M100ika/Kulager_Horse/electrical/power/concept-rA.md

# Питание и резерв батареи rA

В CAD оставлен объём 180 × 70 × 65 мм под готовую защищённую батарею.
Геометрия пакета, химия и ёмкость **не подтверждены**. Для расчёта автономности
принят пример 25,6 В, 4 А·ч (8S LiFePO4), 102,4 Вт·ч; напряжение полного заряда
при 3,65 В/ячейку — 29,2 В. Такой пакет и BMS должны реально помещаться в резерв.

[Страница CubeMars](https://www.cubemars.com/goods.php?id=1143) указывает варианты
24/48 В. Это не подтверждает полный рабочий диапазон имеющейся платы. Перед
подключением сверить конкретный драйвер, минимальное/максимальное напряжение,
пороги защиты и запас под рекуперацию. Для 48-вольтовой версии пакет надо
выбирать заново; 13S Li-ion с 54,6 В нельзя автоматически считать совместимым.
До подтверждения использовать лабораторное питание подходящего диапазона
с ограничением тока. Обычный лабораторный БП может не принимать рекуперацию.

Предлагаемая силовая цепь:

```text
Батарея с BMS → предохранитель у батареи → главный выключатель
  ├─ DC/DC → ESP32 + датчики + журнал отказов
  └─ предзаряд + силовой DC-контактор → шина → предохранители ветвей → 2 мотора

E-stop (NC) + проводной dead-man + аппаратный watchdog
  → аппаратное разрешение → контактор и обе нормально разомкнутые муфты

Шина: измерение напряжения, ёмкость, согласованная защита от рекуперации.
```

Номиналы предохранителей, проводов, контактора, BMS и DC/DC определяются по
измеренным пусковым/рабочим токам, току КЗ, длительности импульса, температуре
и характеристикам отключения. Паспортные 7/19 А мотора не следует без проверки
трактовать как максимальный ток батареи. Ограничение тока БП не заменяет
ограничение силы на поводе.

При эффективной доле энергии 0,8 и среднем потреблении 25/50/100 Вт получаем
примерно 3,28/1,64/0,82 ч. Это сценарии, не обещанная автономность. Измерять
потребление с муфтами и удержанием нагрузки, а также температуру батареи и
моторов. При низком заряде снять натяжение и разомкнуть привод до отключения
BMS. При обрыве питания механика должна отпускать без участия аккумулятора.

CAN: линейная шина, два терминатора 120 Ом на физических концах, короткие
ответвления, CAN_H/CAN_L витой парой, согласованная опорная земля/изоляция.
ESP32 требует [внешнего трансивера](https://docs.espressif.com/projects/esp-idf/en/v5.4/esp32/api-reference/peripherals/twai.html).
Разъёмы драйвера, распиновку, ID и скорость сверить по ревизии его документации.
Нельзя смешивать пакетный формат MIT и servo и считать их взаимозаменяемыми.
