M100ika/Kulager_Horse/mechanical/calculations/concept-rA.md

# Предварительные расчёты rA

Это расчёты выбора компоновки, не заключение о прочности или допустимом
воздействии на животное. Источник данных двигателя:
[CubeMars AK80-64](https://www.cubemars.com/goods.php?id=1143).

## Момент и ход

При рабочем радиусе барабана r = 0,025 м: F = T/r, T = F·r.

| Условие | Момент, Н·м | Сила на барабане, Н |
|---|---:|---:|
| Начальная проверка на стенде | 0,125 | 5 |
| Номинальный момент AK80-64 | 48 | 1920 |
| Пиковый момент AK80-64 | 120 | 4800 |
| Паспортное обратное проворачивание | 4,7 | 188 |

Последние три значения показывают несоответствие мощности привода задаче.
188 Н — оценка сопротивления на барабане при прямом соединении с редуктором,
не точный порог отпускания конкретного экземпляра. Нулевой ток не гарантирует
слабину. Выбор AK80-64 принят по исходному заданию; для последующей версии стоит
сравнить более лёгкий, менее редуцированный привод с высокой обратимостью.

Ход 80 мм: θ = s/r = 3,2 рад = 183,35°. Скорость 10 мм/с:
ω = v/r = 0,4 рад/с = 3,82 об/мин. Мощность одного канала при 5 Н:
P = F·v = 0,05 Вт; потребление электроники, потери мотора и включённая муфта
могут многократно превышать эту механическую мощность.

Уставка механической защиты должна удовлетворять T_max/r_min ≤ F_limit,
где T_max учитывает допуск, температуру, износ и статический срыв муфты;
r_min — минимальный эффективный радиус. Проверять силу динамометром, а не
только ток. Паспортный Kt нельзя без проверки подставлять как коэффициент
выходного момента: влияют редукция, КПД, режим и единицы конкретного протокола.

## Крепление и масса

Масса из объёма Al 6061: m = V·2,7·10⁻⁶ кг при V в мм³; пластика условно
1,2·10⁻⁶. Отдельные CAD-оценки находятся в CSV. Точные материалы, крепёж,
катушки муфт и кабели ещё не выбраны. **Бюджет всей передней сборки 6…8 кг**,
а не 1,7 кг двух моторов. Батарея условно 1,15 кг; значение требует взвешивания.

Для оценки крепления принять верхнюю массу 8 кг, динамический множитель 3
как исходный стендовый сценарий, не стандарт пригодности: Pz ≈ 235 Н.
Если центр масс на 0,15 м впереди опор, M ≈ 35,3 Н·м. Дополнительно при двух
тягах по 5 Н и плече 0,15 м получаем 1,5 Н·м. Реальные ускорения, рывки и
неисправности могут дать другие нагрузки. Декоративные D-кольца нельзя считать
рассчитанными на эти моменты. Требуются измеренный центр масс, реакции четырёх
опор, расчёт болтов/строп/ленчика, усталость и испытание с запасом по утверждённым
критериям. Удалённая батарея снижает момент, но добавляет жгут и риск зацепа.

## Что проверено вычислительно

FreeCAD проверяет ненулевой объём и корректность BRep каждого объекта, а также
шесть критических пар зазоров; отчёт хранится рядом. Это не полный анализ
коллизий во всех положениях и не проверка технологичности. Проверка всех пар
дополнительно сохраняется в `interferences-rA-concept.json`; контактные и
условные интерфейсы оцениваются отдельно. Прочность и ресурс не рассчитывались.
