M100ika/Kulager_Horse/docs/architecture/adr/0001-rein-module-concept.md

# ADR 0001: отдельные тяговые каналы с освобождением при снятии питания

Статус: предложено для стендового прототипа, 2026-10-05.

AK80-64 выбран исходным заданием. Его редукция 64:1 и сопротивление обратному
вращению исключают предположение «выключили мотор — повод свободен».
Принято два барабана с отдельными опорами, муфтами размыкания, механическими
ограничителями и выходными датчиками положения и силы. Ручное отсоединение
тяговых ветвей не зависит от питания и расположено после направляющих.

Телефон передаёт ограниченный запрос воздействия. ESP32 контролирует измеренную
силу, ход и скорость; аппаратная цепь разрешения действует независимо от него.
Управление по положению с жёстким удержанием и прямое задание большого момента
с телефона не принимаются. BLE не считается единственной цепью аварийного стопа.

Цена решения: большая масса, добавленные муфты и датчики, необходимость проверки
отпускания под нагрузкой. Резервы этих изделий в CAD требуют выбора реальных
компонентов. Сборка rA проверяет габариты и путь нагрузок, не реализует полностью
устройства безопасности. Рабочие значения воздействия на лошадь здесь не заданы.

Ссылки: [CAD](../../../mechanical/concept-rA.md),
[управление](../../interfaces/control-concept-rA.md),
[стендовые проверки](../../safety/test-gates.md).
