M100ika/Kulager_Horse/mechanical/drawings/saddle-templates/v1-front-console-rB-templates.png

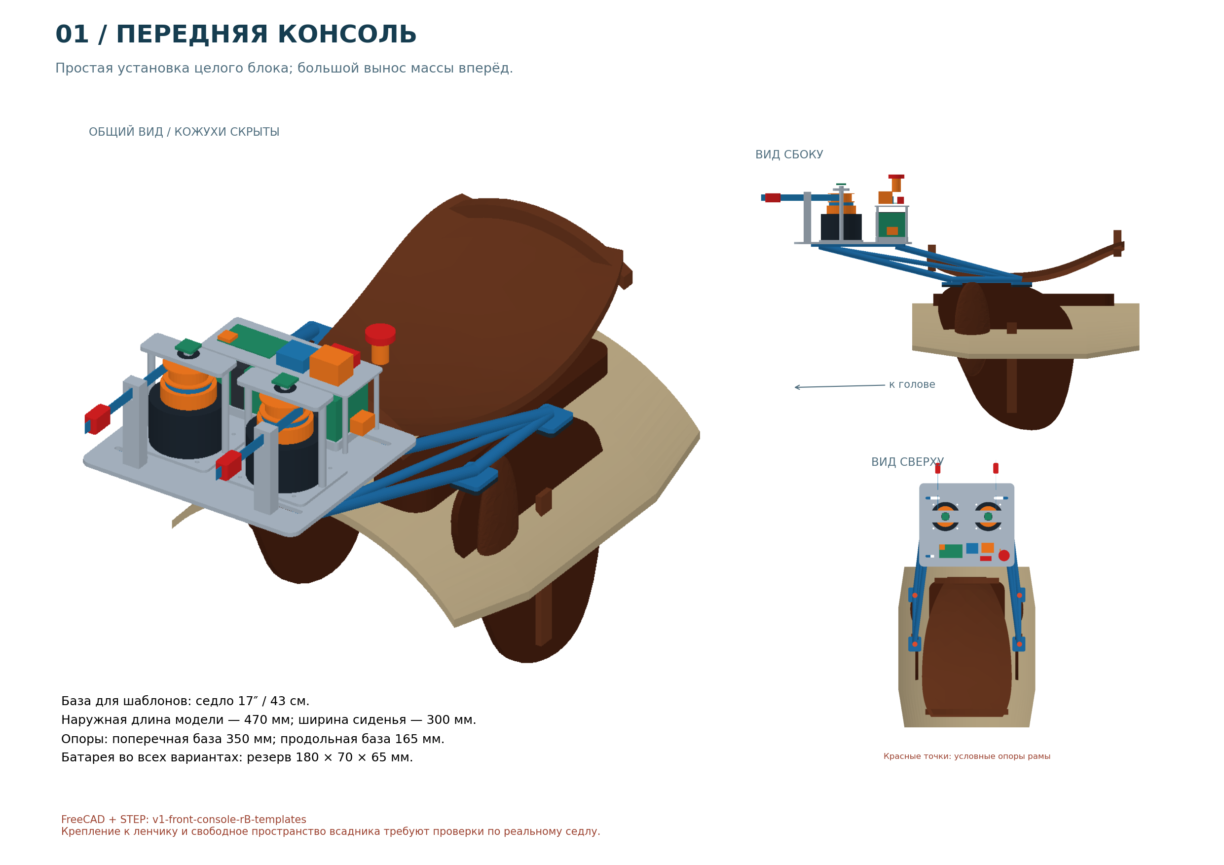
mechanical/drawings/saddle-templates/v1-front-console-rB-templates.png
