M100ika/Kulager_Horse/mechanical/drawings/saddle-templates/v3-side-pods-rB-templates.png

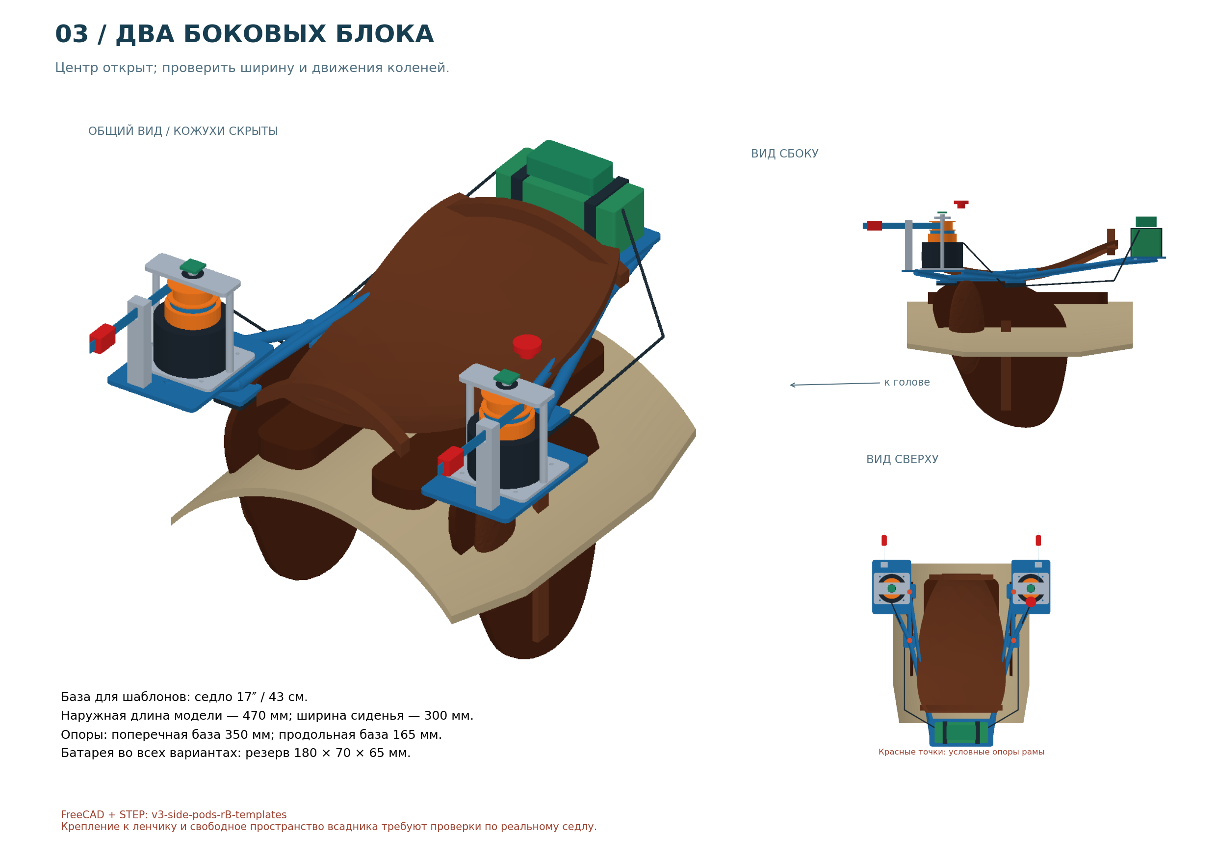
mechanical/drawings/saddle-templates/v3-side-pods-rB-templates.png
