M100ika/Kulager_Horse/mechanical/exports/battery-tray-rA-concept.step

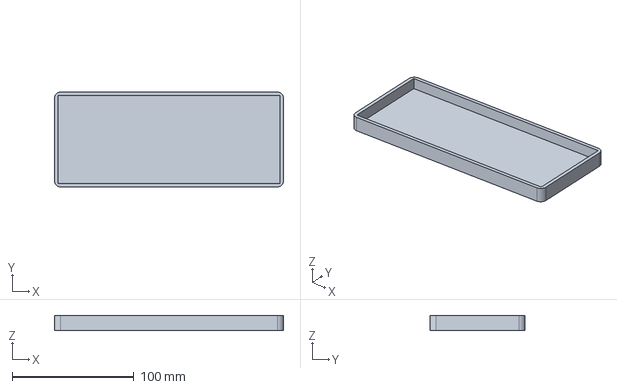
[picture p7: CAD file, 2026-10-09]
mechanical/exports/battery-tray-rA-concept.step
188.0 x 78.0 x 12.0 mm
