M100ika/Kulager_Horse/mechanical/exports/saddle-templates/saddle-reference-17in-rB-templates.step

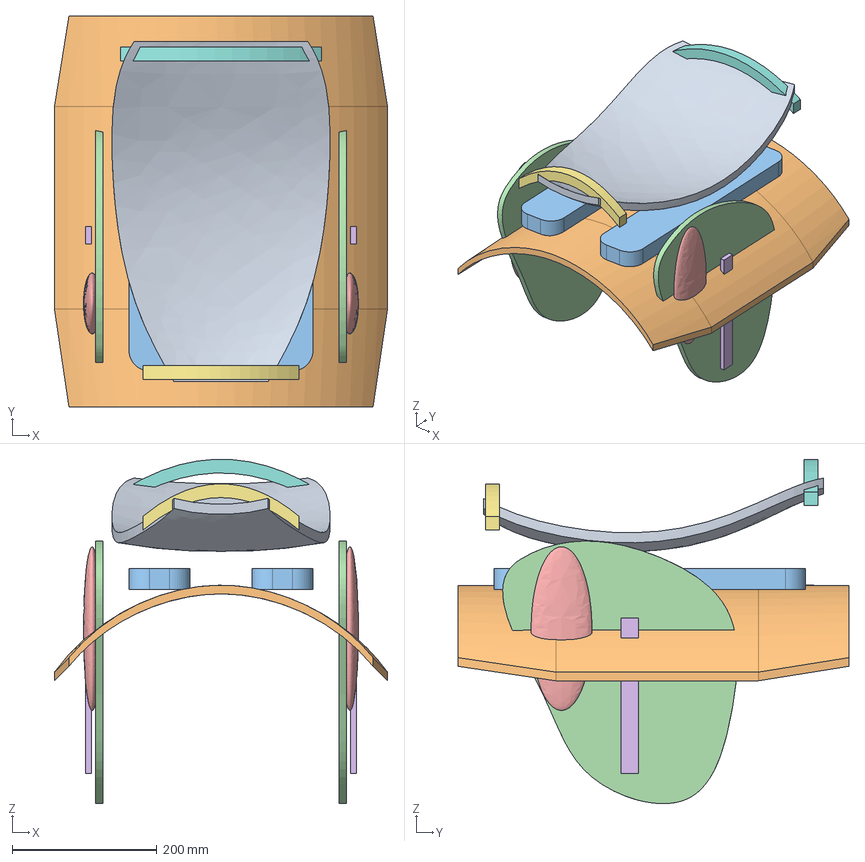
[picture p8: CAD file, 2026-10-09]
mechanical/exports/saddle-templates/saddle-reference-17in-rB-templates.step
460.0 x 540.0 x 475.5 mm
