M100ika/Kulager_Horse/mechanical/cad/assembly/saddle-templates/v1-front-console-rB-templates.FCStd

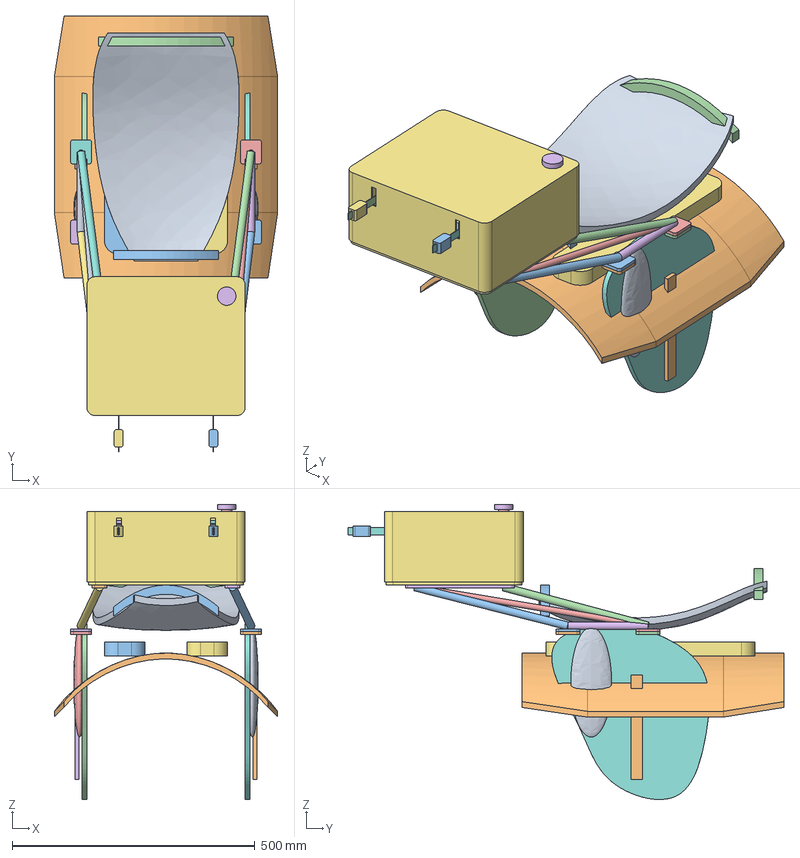
[picture p9: CAD file, 2026-10-09]
mechanical/cad/assembly/saddle-templates/v1-front-console-rB-templates.FCStd
460.0 x 898.0 x 607.7 mm
Сиденье: условный размер 17 дюймов
Вальтрап 540 × 460 — условная поверхность
Подушка седла L
Крыло седла L
Коленный упор L
Условная приструга L
Подушка седла R
Крыло седла R
Коленный упор R
Условная приструга R
Передняя лука
Задняя лука
Прокладка под адаптер L0
Адаптер к ленчику L0
Прокладка под адаптер L1
Адаптер к ленчику L1
Продольная связь адаптеров L
Прокладка под адаптер R0
Адаптер к ленчику R0
Прокладка под адаптер R1
Адаптер к ленчику R1
Продольная связь адаптеров R
Рама / UpperStayL
Рама / RearStayL
Рама / DiagonalL
Съёмный ложемент модуля L
Рама / UpperStayR
Рама / RearStayR
Рама / DiagonalR
Съёмный ложемент модуля R
01.1 / Несущая плита Al 6061, 6 мм
02.1 / L адаптер — сверловка AK80 TBD
02.2 / L AK80-64 Ø98 × 61.9
02.3 / L муфта размыкания NC-off, РЕЗЕРВ
02.4 / L ограничитель момента, РЕЗЕРВ
02.5 / L барабан R25, лента 15 мм
02.6 / L выходной вал Ø12, отдельно от мотора
02.7 / L мост опоры барабана
02.8 / L стойка моста
02.8 / L стойка моста001
02.9 / L опора Ø28/12, РЕЗЕРВ
02.1 / R адаптер — сверловка AK80 TBD
02.2 / R AK80-64 Ø98 × 61.9
02.3 / R муфта размыкания NC-off, РЕЗЕРВ
02.4 / R ограничитель момента, РЕЗЕРВ
02.5 / R барабан R25, лента 15 мм
02.6 / R выходной вал Ø12, отдельно от мотора
02.7 / R мост опоры барабана
02.8 / R стойка моста
02.8 / R стойка моста001
02.9 / R опора Ø28/12, РЕЗЕРВ
03.1 / L тяговая лента → быстросброс → повод
03.2 / L направляющая с датчиком усилия, РЕЗЕРВ
03.3 / L стойка направляющей
03.4 / L размыкатель под нагрузкой, РЕЗЕРВ
03.1 / R тяговая лента → быстросброс → повод
03.2 / R направляющая с датчиком усилия, РЕЗЕРВ
03.3 / R стойка направляющей
03.4 / R размыкатель под нагрузкой, РЕЗЕРВ
04.1 / Съёмный лоток батареи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
