M100ika/Kulager_Horse/mechanical/exports/saddle-templates/v4-front-rear-battery-rB-templates.step

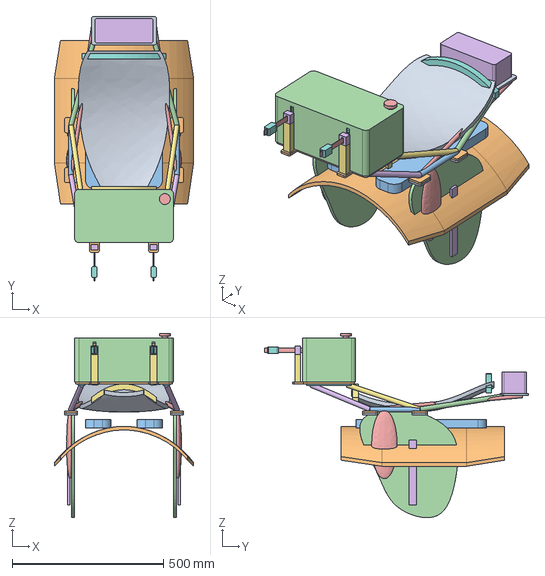
[picture p10: CAD file, 2026-10-09]
mechanical/exports/saddle-templates/v4-front-rear-battery-rB-templates.step
460.0 x 872.0 x 608.7 mm
