M100ika/Kulager_Horse/mechanical/exports/base-rA-concept.step

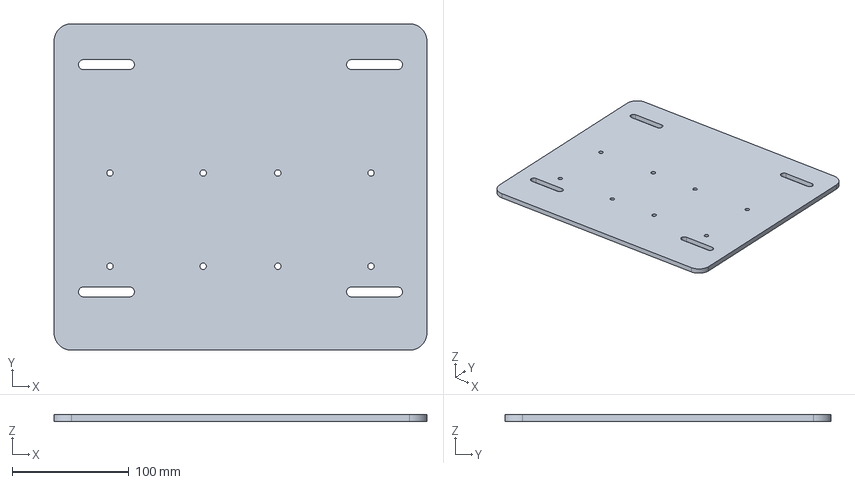
[picture p12: CAD file, 2026-10-09]
mechanical/exports/base-rA-concept.step
320.0 x 280.0 x 6.00 mm
