M100ika/Kulager_Horse/mechanical/exports/motor-adapter-blank-rA-concept.step

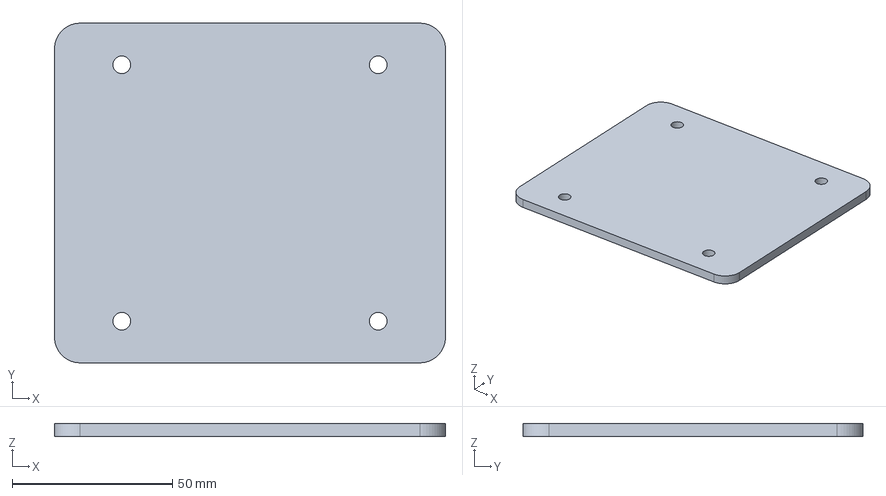
[picture p14: CAD file, 2026-10-09]
mechanical/exports/motor-adapter-blank-rA-concept.step
122.0 x 106.0 x 4.00 mm
