M100ika/Kulager_Horse/mechanical/exports/rein-drum-rA-concept.step

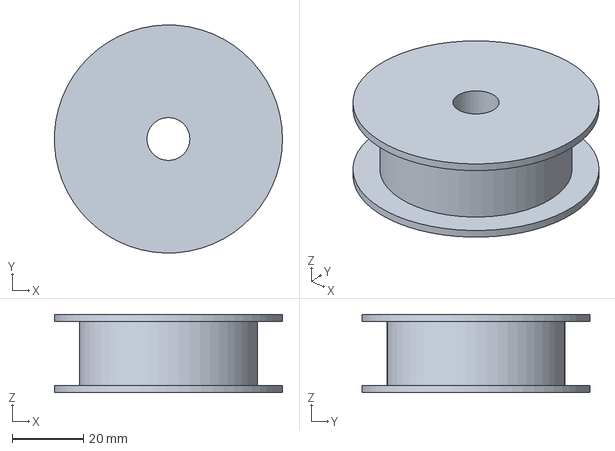
[picture p15: CAD file, 2026-10-09]
mechanical/exports/rein-drum-rA-concept.step
64.0 x 64.0 x 22.0 mm
