M100ika/Kulager_Horse/mechanical/exports/guard-rA-concept.step

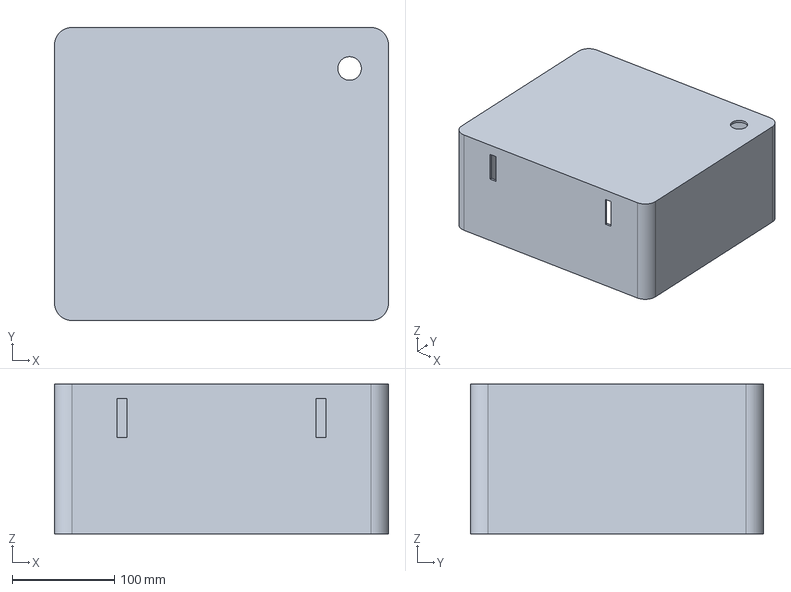
[picture p16: CAD file, 2026-10-09]
mechanical/exports/guard-rA-concept.step
326.0 x 286.0 x 146.0 mm
