M100ika/Kulager_Horse/(list of files, cad)

Other CAD files:
mechanical/exports/kulager-module-rA-concept.step
mechanical/exports/saddle-templates/v1-front-console-rB-templates.step
mechanical/exports/saddle-templates/v2-pommel-bridge-rB-templates.step
mechanical/cad/assembly/saddle-templates/saddle-reference-17in-rB-templates.FCStd
mechanical/exports/saddle-templates/v3-side-pods-rB-templates.step
mechanical/cad/assembly/saddle-templates/v4-front-rear-battery-rB-templates.FCStd
mechanical/exports/battery-tray-rA-concept.stl
mechanical/exports/guard-rA-concept.stl
