M100ika/Kulager_Horse/docs/safety/test-gates.md

# Последовательность допуска rA

Все пункты пока **не пройдены**. CAD-проверка не заменяет физический стенд.

1. **Сверка комплектующих.** Ревизия драйвера и напряжение; моторные посадки;
   реальные муфты, датчики и защита; номиналы всей силовой цепи.
2. **Стенд без поводьев и животного.** Низкая скорость, ограниченное питание;
   проверить направления, единицы протокола, ноль датчиков и выходные энкодеры.
3. **Пружинный/грузовой имитатор.** Два динамометра и независимый регистратор;
   начальные пределы 5 Н, 80 мм, 10 мм/с. Проверить перерегулирование и выброс
   силы. Калибровать во всём ходе и при разных углах выхода ленты.
4. **Отказы под нагрузкой.** По отдельности: потеря BLE, CAN, ESP32, питания,
   обрыв датчика, залипшая команда, заклинивание барабана, отказ муфты, сваренный
   контактор. Повторять на обоих каналах и одновременно. Измерять время до
   освобождения и остаточное натяжение, а не только факт выключения светодиода.
   Предварительная стендовая цель: от обнаружения отказа до остатка <1 Н за
   <100 мс; для BLE добавить до 200 мс детектирования. Это требование для
   исследования, не достигнутый результат и не обоснованный предел для лошади.
5. **Ручной сброс.** При заклинившем приводе и обесточенном модуле один оператор
   должен освободить обе тяговые ветви под максимальной стендовой нагрузкой.
   Зафиксировать усилие рукоятки, время, отсутствие повторного захвата и петель.
6. **Макет седла.** Проверить реакции креплений, динамическую нагрузку,
   раскачивание, инструментальный доступ, проводку, зацепы и весь диапазон
   относительных перемещений. До испытаний утвердить нагрузки с учётом реальной
   массы, ускорений и конструкции седла. Вибрационные и ресурсные режимы пока TBD.
7. **Тепло и среда.** Максимальное удержание, циклы, разряд, грязь и вода;
   контролировать нагрев, коррозию и изменение остаточного трения.
8. **Решение о дальнейшем этапе.** Только после протоколов выше, обмера седла
   и определения допустимого воздействия специалистами по лошадям и инженером
   по безопасности. Пределы задавать по конкретной уздечке, животному и сценарию.

Протокол каждого опыта: версия CAD/прошивки, схемы, серийные номера,
калибровка, нагрузка, напряжение, временные ряды двух сил и положений,
действие оператора, время отпускания, фото установки, результат и замечания.
