M100ika/Kulager_Horse/mechanical/drawings/kulager-layout-rA-concept.pdf

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

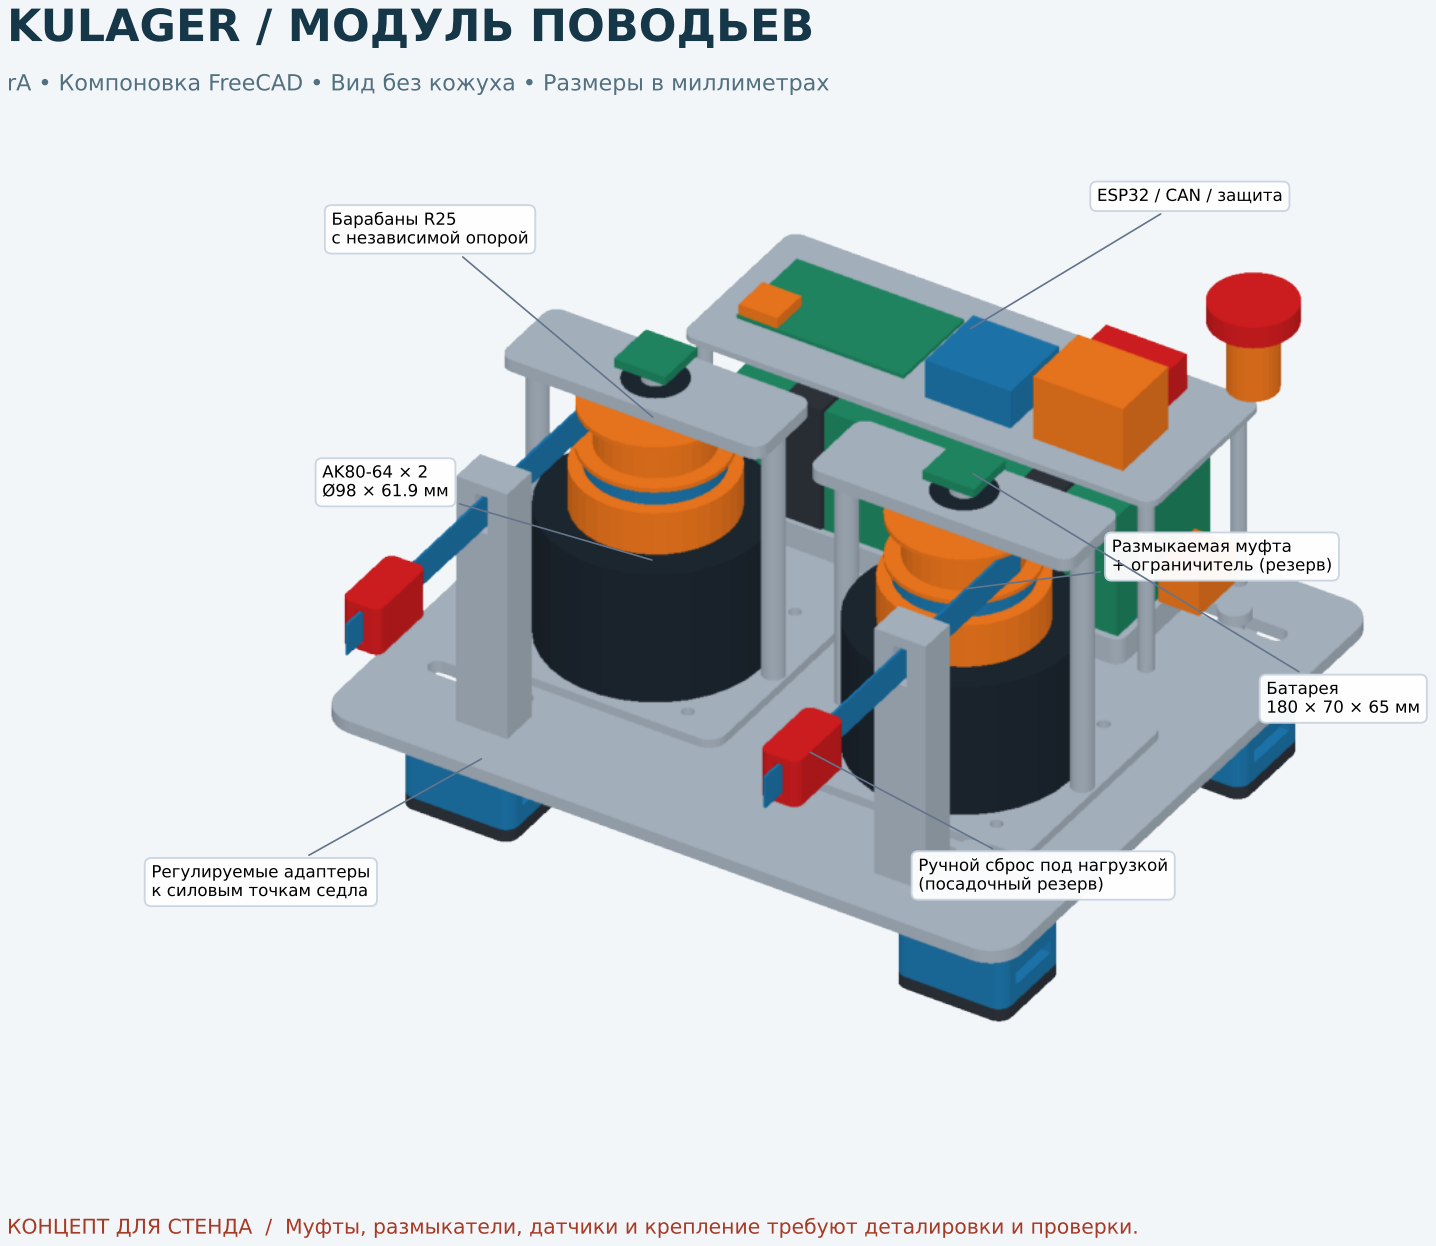
[picture p17: page 1]

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

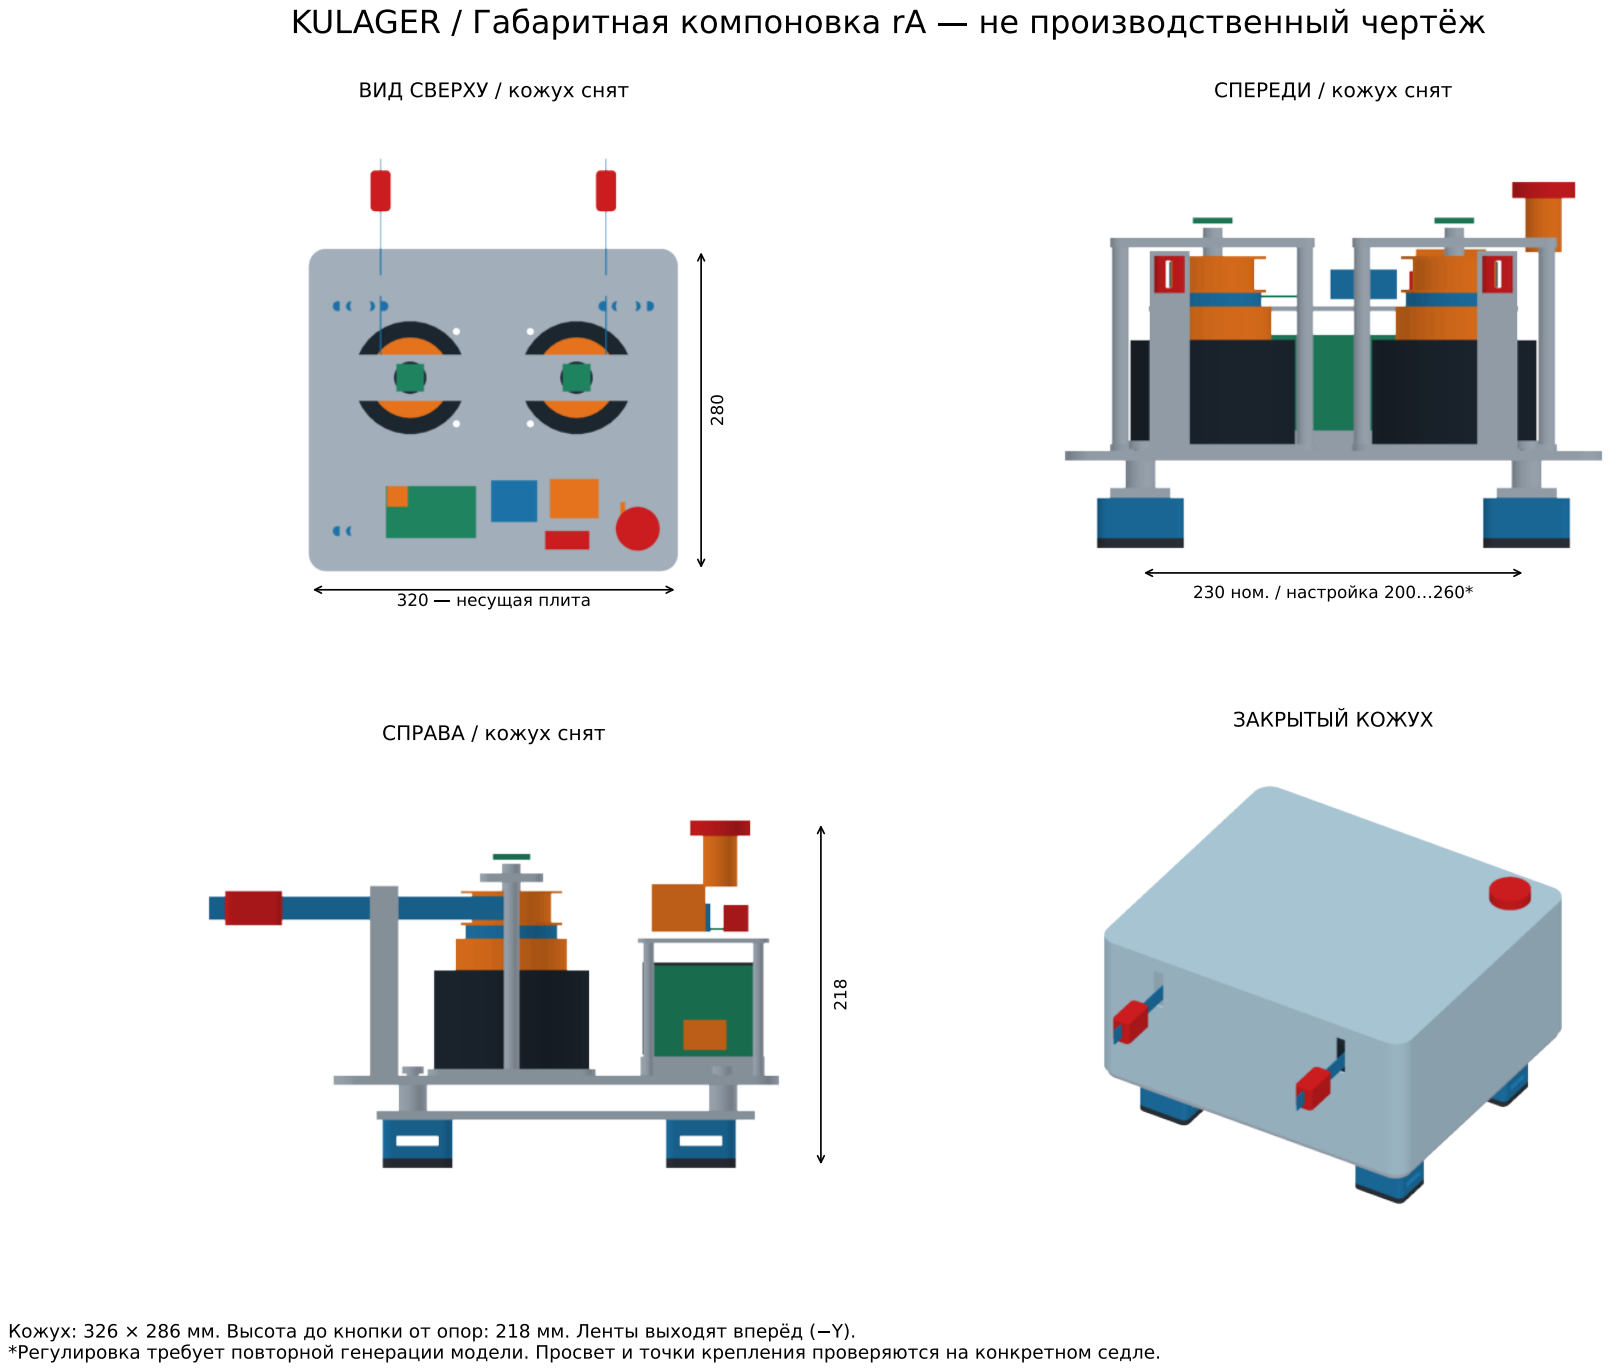
[picture p18: page 2]
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
