M100ika/Kulager_Horse/(commit log)

2026-10-05 Initial project structure
    Discipline-based layout: docs, mechanical (FreeCAD), electrical (KiCad),
    firmware (PlatformIO / ESP32), control (mobile app), tools.
2026-10-09 Добавить концепт модуля rA и шаблоны крепления к седлу rB
    Компоновка rA в FreeCAD: два привода AK80-64 с барабанами, регулируемая
    рама, резервы муфт, батареи и ESP32/CAN, экспорт STEP/STL и габаритный PDF,
    скрипты генерации и проверки, расчёты. Четыре варианта установки на седло
    rB со сравнительными видами.
    Документы: ADR 0001 о независимых каналах повода, концепт управления,
    анализ отказов, порядок стендо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
    [base-rA-concept.step, battery-tray-rA-concept.step, battery-tray-rA-concept.stl, bom-rA-concept.csv, cad-parts-rA-concept.csv, guard-rA-concept.step, guard-rA-concept.stl, kulager-module-rA-concept.FCStd]
2026-10-09 Добавить стендовый тест AK80-64 и пульт на ПК
    ak80-mega-test: Arduino Mega + MCP2515, протокол MIT с тестами на ПК,
    проверка мотора на стенде, поиск CAN ID и интерактивная консоль с ходами,
    вращением, циклами, защитами, статистикой и телеметрией CSV.
    ak80-gui: пульт на PySide6 поверх консоли: кнопки, графики позиции,
    скорости и момента, таблица ходов со сводкой, запись телеметрии в CSV.
2026-10-09 Добавить правила работы с репозиторием
    CONTRIBUTING.md: ветки и запрет прямого push в main, документирование
    и журналы веток, коммиты, pull request, задачи, хранение файлов, среда
    разработки и общий формат 3D-моделей (STEP), использование ИИ,
    выбранные рекомендации GitHub.
    Шаблон pull request, CODEOWNERS, формат журнала в docs/worklog/.
    В README: запуск пульта мотора на стенде и ссылка на Google Drive.
